CollaboratorimInstitute/Workshop.Cafe/docs/troubleshooting/thomasInstallNotes.txt

Female female on the heads of the wires

easily accessible ports

pucks instead of coils

nested forstner bit

white and blue

light on the top of the led puck

two point neopixel leds
