CollaboratorimInstitute/Workshop.Cafe/docs/troubleshooting/index.html

# Workshop Cafe Test Buttons

1 2 3 4 5 6 7 8

1 2 3 4 5 6 7 8

1 2 3 4 5 6 7 8

1 2 3 4 5 6 7 8
