CollaboratorimInstitute/Workshop.Cafe/(commit log)

2017-03-04 assembly done
2017-03-19 Updated landing page for project
2017-04-21 Updated firmware file and altered mistakes in documentation materials.
2017-06-05 Updates From Newton
    On Jun 5, 2017, 10:48 -0700, Newton Sun <newton.sun@workshopcafe.com>, wrote:
    Will,
    None of the questions/comments I sent on 4/26 in the "Weekly Update 2017.04.10" email thread have been addressed yet. Pasted here for reference:
    Will,
    Thanks for updating the documentation at https://github.com/CollaboratorimInstitute/Workshop.Cafe . A few questions/comments below. The most important question/comment being "Where is the source code?:
    Attached and published
    https://github.com/CollaboratorimInstitute/Workshop.Cafe#particle-usage-and-management
    - link to console.particl.io doesn't work due to missing "e" at the end of "particle"
    - Question: For the "Then select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
